MSandro93/BT_Alpha/Jobset/BT_Alpha_SCH.pdf

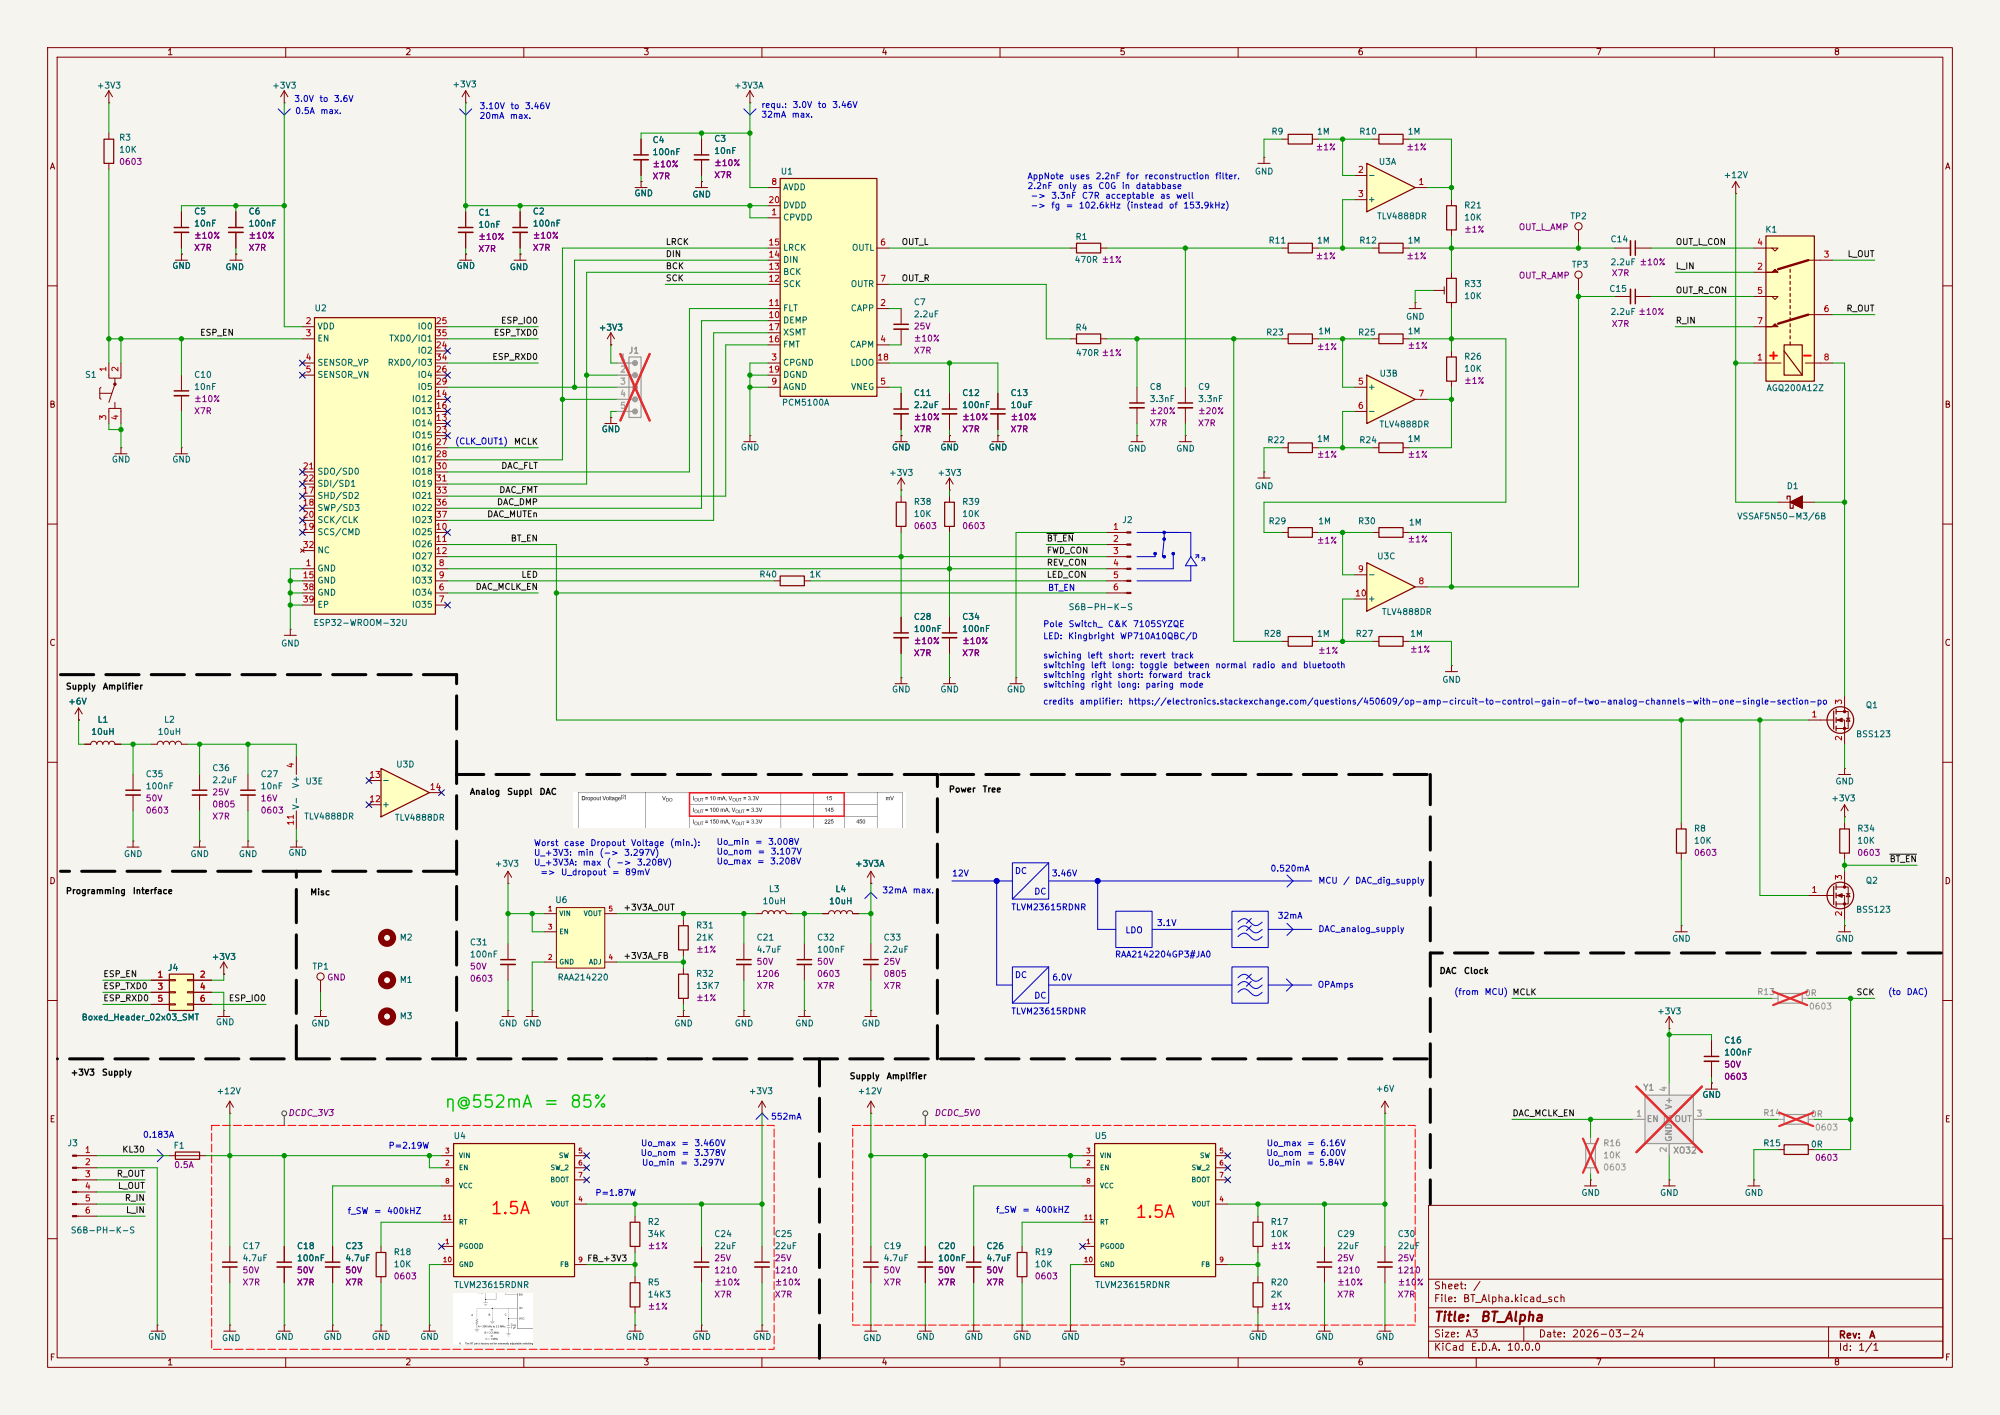
[picture p1: page 1]

AppNote uses 2.2nF for reconstruction filter. 2.2nF only as C0G in databbase -> 3.3nF C7R acceptable as well -> fg = 102.6kHz (instead of 153.9kHz)

Pole Switch_ C&K 7105SYZQE 32mA max. Analog Suppl DAC

swiching left short: revert track
switching left long: toggle between normal radio and bluetooth
switching right short: forward track

switching right long: paring mode C18

credits amplifier: https://electronics.stackexchange.com/questions/450609/op-amp-circuit-to-control-gain-of-two-analog-channels-with-one-single-section-po

Worst case Dropout Voltage (min.):
U_+3V3: min (-> 3.297V)

Size: A3 | Rev: A | F Date: 2026-03-24 KiCad E.D.A. 10.0.0
