MSandro93/BT_Alpha/Jobset/BT_Alpha_ASD.pdf

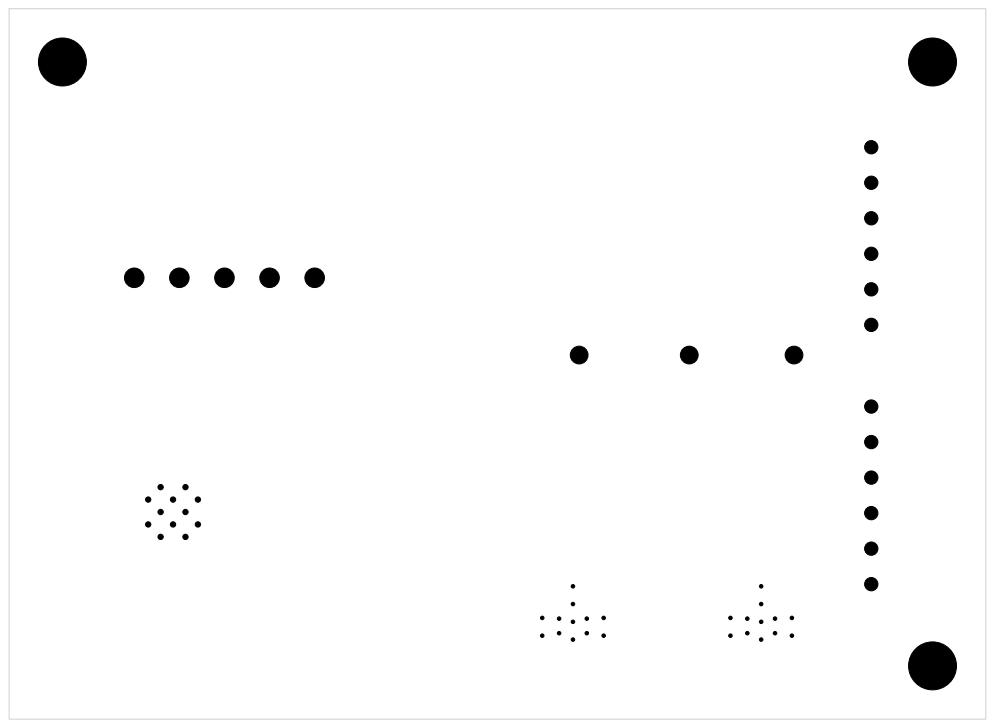
[picture p2: page 1]

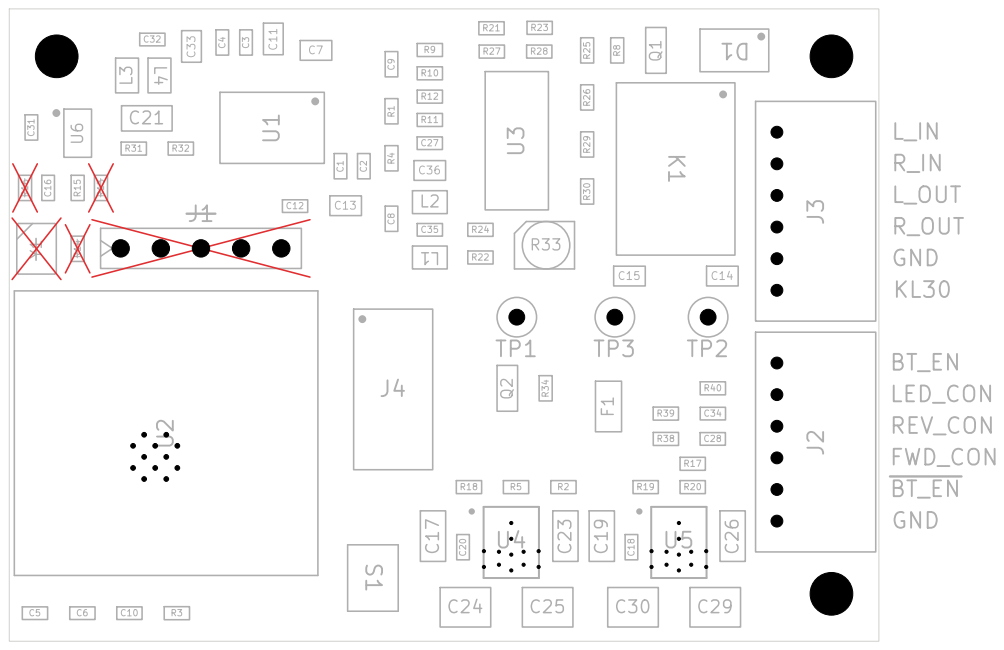
[picture p3: page 2]
