MSandro93/BT_Alpha/Jobset/BT_Alpha_Dimensions.pdf

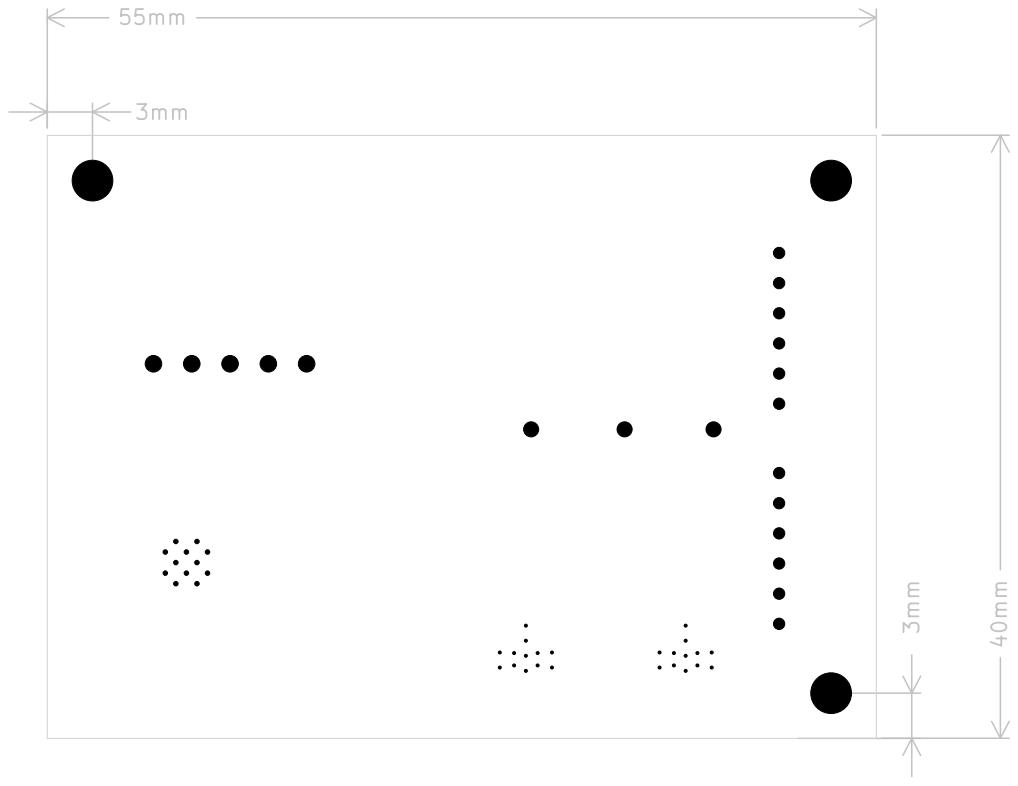
[picture p4: page 1]
