MSandro93/BT_Alpha/BT_Alpha.kicad_pcb

## KiCad design BT_Alpha.kicad_pcb (2026-05-01)

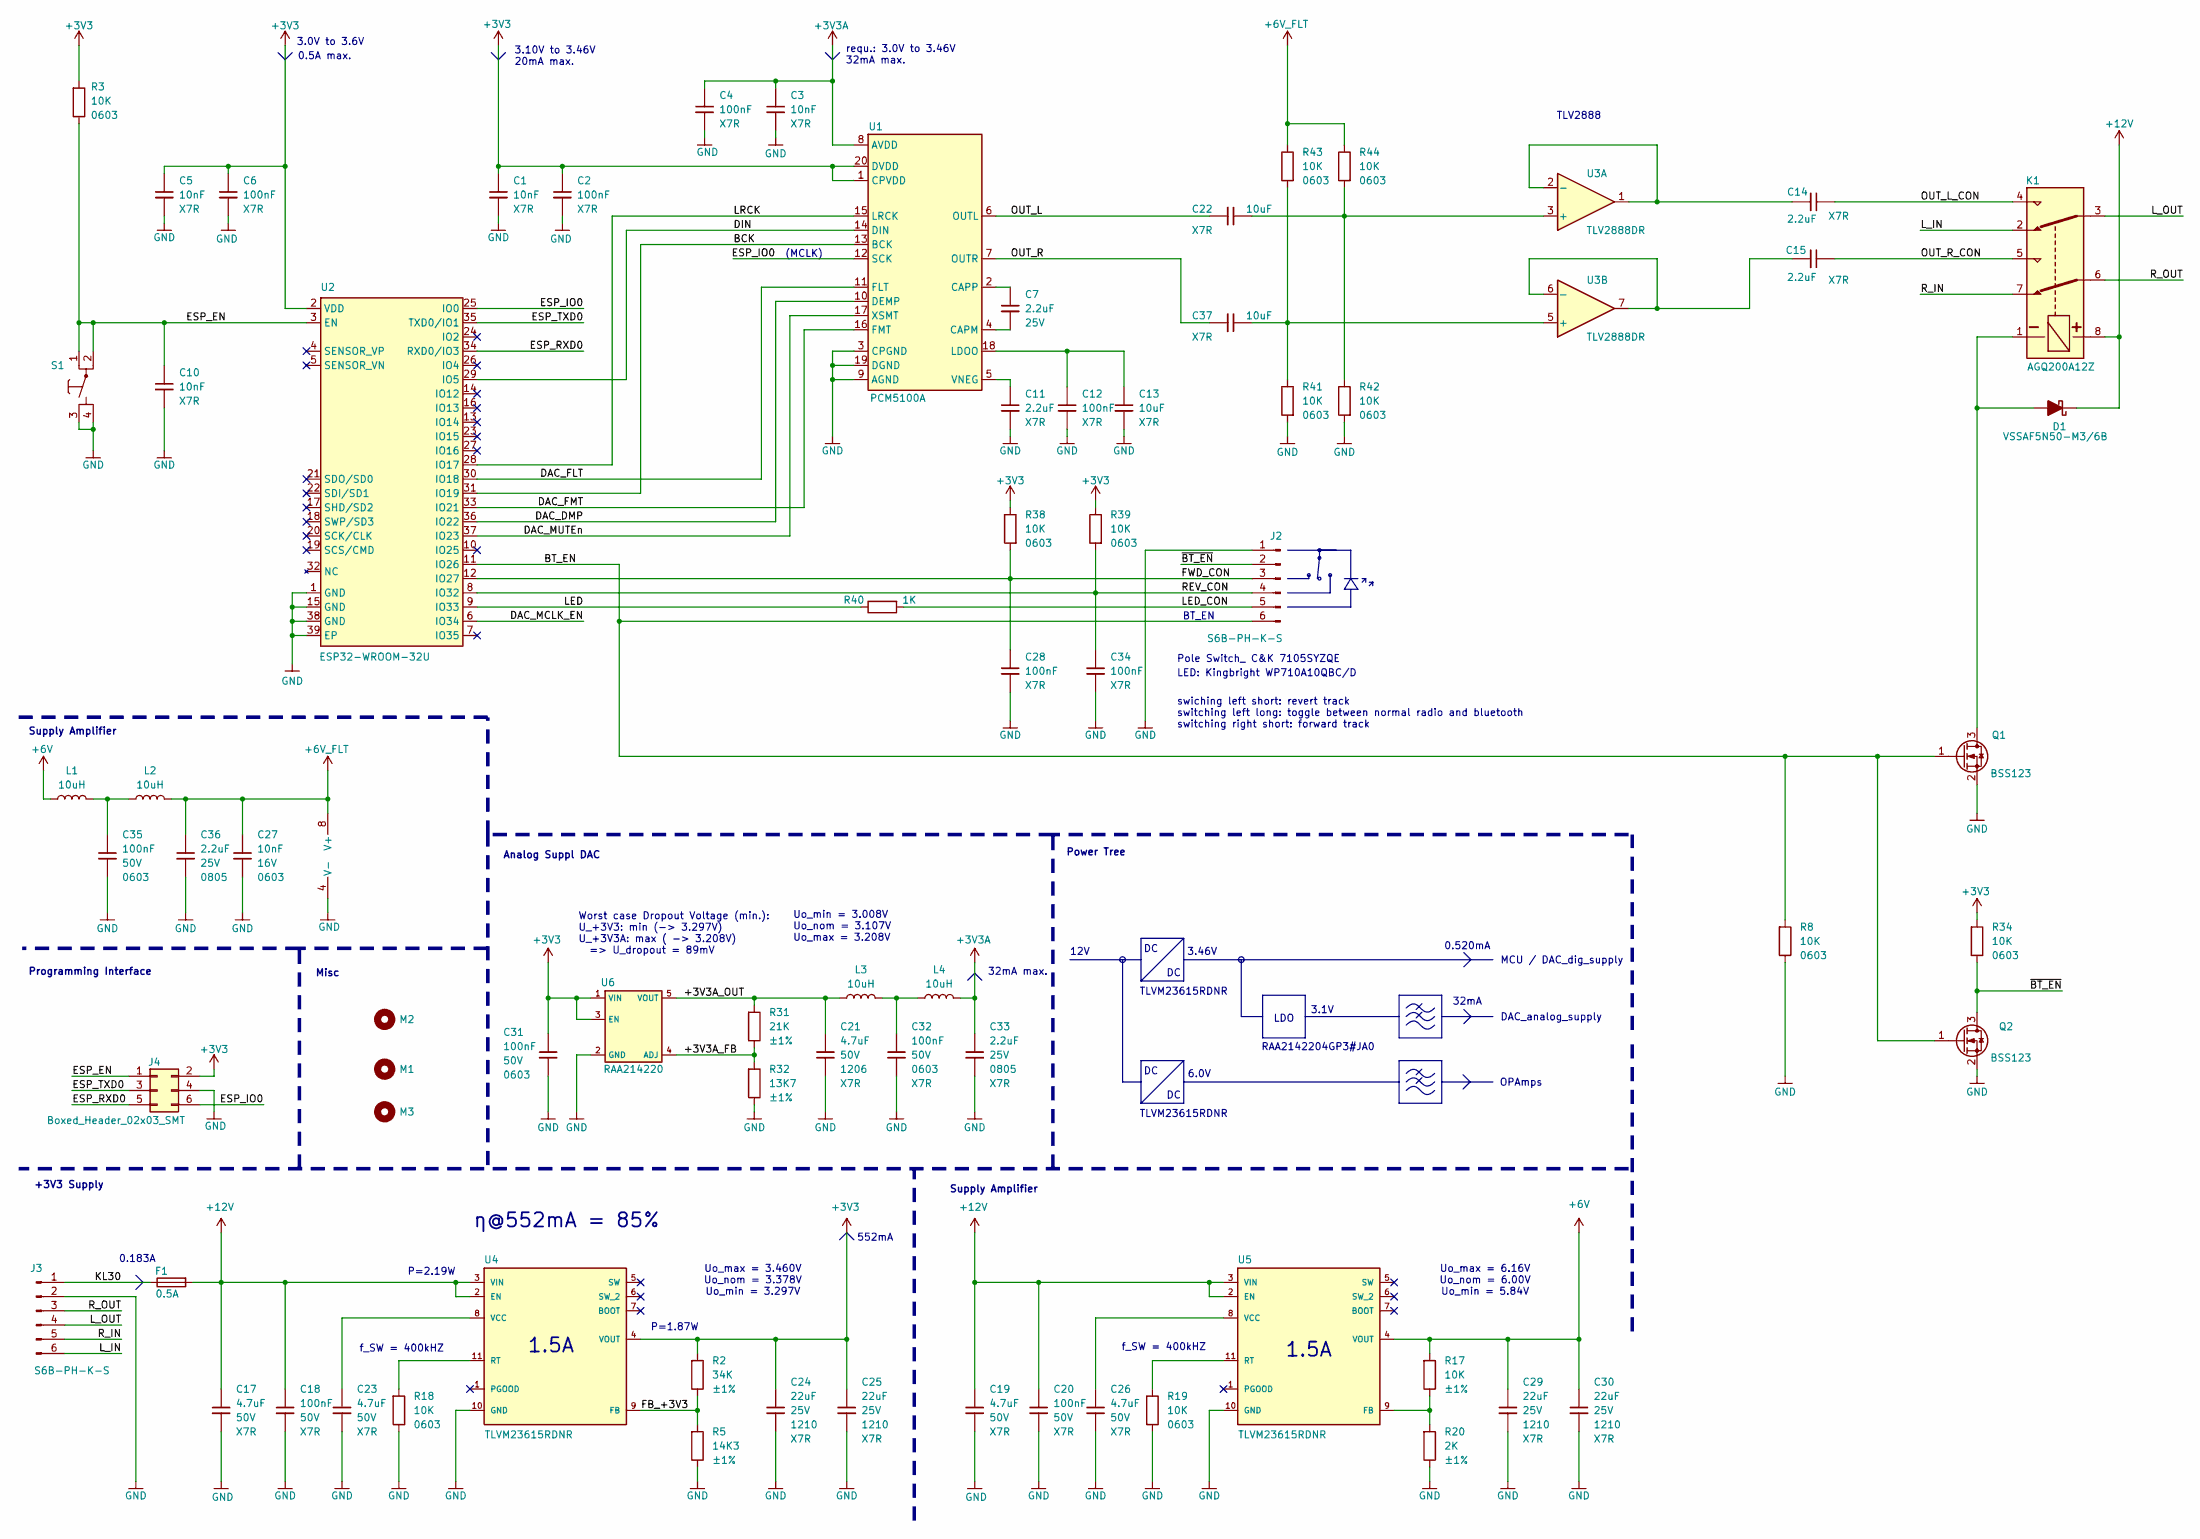
[picture p5: schematic BT_Alpha.kicad_sch]

Parts:
C1, C3, C5, C10, C27: 10nF; C_0603; Voltage 16V; Voltage [V] 16; Manufacturer Part Number 0603YC103KAT2A
C2, C4, C6, C12, C18, C20, C28, C31, C32, C34, C35: 100nF; C_0603; Voltage 50V; Voltage [V] 50; Manufacturer Part Number CL10B104KB8NNNC
C7, C11, C14, C15, C33, C36: 2.2uF; C_0805; Voltage 25V; Voltage [V] 25; Manufacturer Part Number CL21B225KAFNNNE
C13, C22, C37: 10uF; C_0805; Voltage 16V; Voltage [V] 16; Manufacturer Part Number CL21B106KOQNNNG
C17, C19, C21, C23, C26: 4.7uF; C_1206; Voltage 50V; Voltage [V] 50; Manufacturer Part Number CL31B475KBHNNNE
C24, C25, C29, C30: 22uF; C_1210; Voltage 25V; Voltage [V] 25; Manufacturer Part Number CL32B105KAFNNNE
D1: VSSAF5N50-M3/6B; VSSAF5N50; Voltage 0.56V; Voltage [V] 0.56; Manufacturer Part Number VSSAF5N50-M3/6B
F1: SF-1206S050-2; SF-1206S; Voltage [V] 63; Voltage 63VDC; Manufacturer Part Number SF-1206S050-2
J2, J3: S6B-PH-K-S; Manufacturer Part Number S6B-PH-K-S
J4: Boxed_Header_02x03_SMT
K1: AGQ200A12Z; AGQ200Axxx; Voltage [V] 12; Voltage 12V; Manufacturer Part Number AGQ200A12Z
L1, L2, L3, L4: 10uH; 74479777310; Manufacturer Part Number 74479777310
M1, M2, M3: Mounting_Hole_2.7mm_Unplated
Q1, Q2: BSS123; Voltage 100V; Voltage [V] 100; Manufacturer Part Number BSS123
R2: 34K; R_0603; Voltage 150V; Voltage [V] 150; Manufacturer Part Number RC0603FR-0734KL
R3, R8, R17, R18, R19, R34, R38, R39, R41, R42, R43, R44: 10K; R_0603; Voltage 150V; Voltage [V] 150; Manufacturer Part Number RC0603FR-0710KL
R5: 14K3; R_0603; Voltage 150V; Voltage [V] 150; Manufacturer Part Number RC0603FR-0714K3L
R20: 2K; R_0603; Voltage 150V; Voltage [V] 150; Manufacturer Part Number RC0603FR-0714K3L
R31: 21K; R_0603; Voltage 150V; Voltage [V] 150; Manufacturer Part Number RC0603FR-0721KL
R32: 13K7; R_0603; Voltage 150V; Voltage [V] 150; Manufacturer Part Number RC0603FR-0713K7L
R40: 1K; R_0603; Voltage 150V; Voltage [V] 150; Manufacturer Part Number RC0603FR-071KL
S1: 434123025826; Manufacturer Part Number 434123025826
U1: PCM5100A; PCM510xx; Manufacturer Part Number PCM5100A
U2: ESP32-WROOM-32U; WROOM_32U; Voltage 3.0 - 3.6; Voltage [V] 3.0V - 3.6V; Manufacturer Part Number ESP32-WROOM-32UE-N8
U3: TLV2888DR; Manufacturer Part Number TLV2888DR
U4, U5: TLVM23615RDNR; TxxM336x5; Manufacturer Part Number TLVM23615RDNR
U6: RAA214220; Manufacturer Part Number RAA2142204GP3#JA0

Connections:
+3V3: C1.1, C2.1, C5.1, C6.1, C24.1, C25.1, C31.1, J4.2, R2.1, R3.1, R34.1, R38.2, R39.2, U1.1 (CPVDD), U1.20 (DVDD), U2.2 (VDD), U4.4 (VOUT), U6.1 (VIN), U6.3 (EN)
+3V3A: C3.1, C4.1, C33.1, L4.2, U1.8 (AVDD)
+6V: C29.1, C30.1, L1.1, R17.1, U5.4 (VOUT)
+6V_FLT: C27.1, C36.1, L2.2, R43.2, R44.2, U3.8 (V+)
+12V: C17.1, C18.1, C19.1, C20.1, D1.K, F1.1, K1.8, U4.2 (EN), U4.3 (VIN), U5.2 (EN), U5.3 (VIN)
/+3V3A_FB: R31.2, R32.1, U6.4 (ADJ)
/+3V3A_OUT: C21.1, L3.1, R31.1, U6.5 (VOUT)
/BCK: U1.13 (BCK), U2.31 (IO19)
/BT_EN: J2.6, Q1.1 (G), Q2.1 (G), R8.1, U2.11 (IO26)
/DAC_DMP: U1.10 (DEMP), U2.36 (IO22)
/DAC_FLT: U1.11 (FLT), U2.30 (IO18)
/DAC_FMT: U1.16 (FMT), U2.33 (IO21)
/DAC_MCLK_EN: U2.6 (IO34)
/DAC_MUTEn: U1.17 (XSMT), U2.37 (IO23)
/DIN: U1.14 (DIN), U2.29 (IO5)
/ESP_EN: C10.1, J4.1, R3.2, S1.1, S1.2, U2.3 (EN)
/ESP_IO0: J4.6, U1.12 (SCK), U2.25 (IO0)
/ESP_RXD0: J4.5, U2.34 (RXD0/IO3)
/ESP_TXD0: J4.3, U2.35 (TXD0/IO1)
/FB_+3V3: R2.2, R5.1, U4.9 (FB)
/FWD_CON: C28.1, J2.3, R38.1, U2.12 (IO27)
/KL30: F1.2, J3.1
/LED: R40.2, U2.9 (IO33)
/LED_CON: J2.5, R40.1
/LRCK: U1.15 (LRCK), U2.28 (IO17)
/L_IN: J3.6, K1.2
/L_OUT: J3.4, K1.3
/OUT_L: C22.2, U1.6 (OUTL)
/OUT_L_CON: C14.1, K1.4
/OUT_R: C37.2, U1.7 (OUTR)
/OUT_R_CON: C15.1, K1.5
/REV_CON: C34.1, J2.4, R39.1, U2.8 (IO32)
/R_IN: J3.5, K1.7
/R_OUT: J3.3, K1.6
/~BT_EN: J2.2, Q2.3 (D), R34.2
GND: C1.2, C2.2, C3.2, C4.2, C5.2, C6.2, C10.2, C11.2, C12.2, C13.2, C17.2, C18.2, C19.2, C20.2, C21.2, C23.2, C24.2, C25.2, C26.2, C27.2, C28.2, C29.2, C30.2, C31.2, C32.2, C33.2, C34.2, C35.2, C36.2, J2.1, J3.2, J4.4, Q1.2 (S), Q2.2 (S), R5.2, R8.2, R18.2, R19.2, R20.2, R32.2, R41.1, R42.1, S1.3, S1.4, U1.3 (CPGND), U1.9 (AGND), U1.19 (DGND), U2.1 (GND), U2.15 (GND), U2.38 (GND), U2.39 (EP), U3.4 (V-), U4.10 (GND), U5.10 (GND), U6.2 (GND)
unnamed: C32.1, L3.2, L4.1
unnamed: C35.1, L1.2, L2.1
unnamed: D1.A, K1.1, Q1.3 (D)
unnamed: C7.2, U1.4 (CAPM)
unnamed: C7.1, U1.2 (CAPP)
unnamed: C12.1, C13.1, U1.18 (LDOO)
unnamed: C11.1, U1.5 (VNEG)
unnamed: C22.1, R42.2, R44.1, U3.3 (+)
unnamed: C14.2, U3.1, U3.2 (-)
unnamed: C37.1, R41.2, R43.1, U3.5 (+)
unnamed: C15.2, U3.6 (-), U3.7
unnamed: R18.1, U4.11 (RT)
unnamed: C23.1, U4.8 (VCC)
unnamed: R17.2, R20.1, U5.9 (FB)
unnamed: R19.1, U5.11 (RT)
unnamed: C26.1, U5.8 (VCC)

Notes on the sheet:
32mA
Supply Amplifier
Worst case Dropout Voltage (min.): U_+3V3: min (-> 3.297V) U_+3V3A: max ( -> 3.208V) => U_dropout = 89mV
DAC_analog_supply
Misc
32mA max.
1.5A
MCU / DAC_dig_supply
Power Tree
f_SW = 400kHZ
0.183A
requ.: 3.0V to 3.46V 32mA max.
Uo_min = 3.008V Uo_nom = 3.107V Uo_max = 3.208V
RAA2142204GP3#JA0
OPAmps
0.520mA
BT_EN
P=2.19W
552mA
0.5A max.
η@552mA = 85%
LED: Kingbright WP710A10QBC/D
Pole Switch_ C&K 7105SYZQE
+3V3 Supply
Uo_max = 6.16V Uo_nom = 6.00V Uo_min = 5.84V
3.10V to 3.46V 20mA max.
Uo_max = 3.460V Uo_nom = 3.378V Uo_min = 3.297V
(MCLK)
TLVM23615RDNR
3.1V
LDO
6.0V
TLV2888
P=1.87W
3.0V to 3.6V
swiching left short: revert track switching left long: toggle between normal radio and bluetooth switching right short: forward track
12V
Programming Interface
Analog Suppl DAC
3.46V

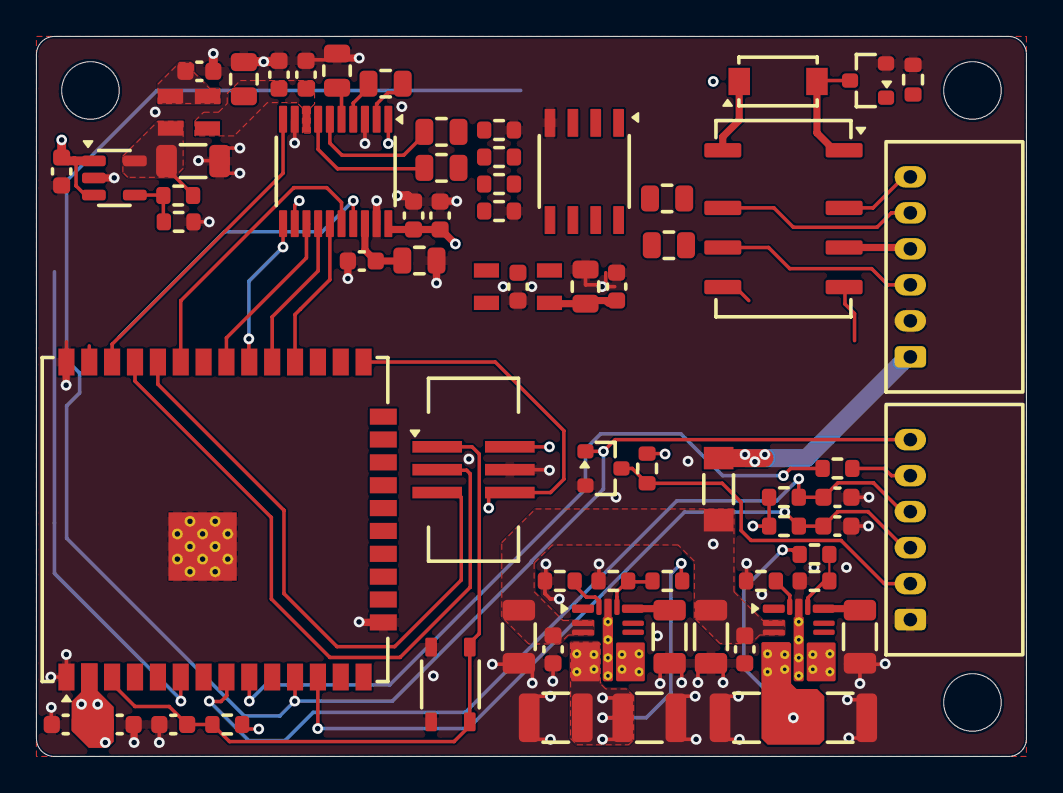
[picture p6: board BT_Alpha.kicad_pcb from above]

Board: 4 copper layers, 55.0 x 40.0 mm, 74 parts (0 on the bottom side), 51 nets.
