MSandro93/BT_Alpha/FW/BT_Alpha/include/BluetoothA2DPSinkQueued.h

#pragma once

#include "BluetoothA2DPSink.h"

#if IS_VALID_PLATFORM

#define RINGBUF_HIGHEST_WATER_LEVEL (32 * 1024)
#define RINGBUF_PREFETCH_PERCENT 65

enum A2DPRingBufferMode : char {
  RINGBUFFER_MODE_PROCESSING,  /* ringbuffer is buffering incoming audio data,
                                  I2S is working */
  RINGBUFFER_MODE_PREFETCHING, /* ringbuffer is buffering incoming audio data,
                                  I2S is waiting */
  RINGBUFFER_MODE_DROPPING /* ringbuffer is not buffering (dropping) incoming
                              audio data, I2S is working */
};

/**
 * @brief BluetoothA2DPSinkQueued provides an A2DP sink implementation with a
 * queued, task-based I2S output to address the volume delay and jitter issues
 * observed in the standard BluetoothA2DPSink implementation, especially under
 * high load or with certain Bluetooth sources.
 *
 * This class extends BluetoothA2DPSink by introducing a dedicated FreeRTOS task
 * and a ring buffer for handling audio data. Incoming audio data is buffered in
 * the ring buffer and then written to the I2S interface by the background task.
 * This design helps decouple Bluetooth and I2S timing, improving robustness
 * against jitter and allowing for prefetching and flow control.
 *
 * The ring buffer operates in different modes, controlled by the enum
 * ::A2DPRingBufferMode:
 *   - RINGBUFFER_MODE_PROCESSING: Buffering and playback are active (normal
 * operation).
 *   - RINGBUFFER_MODE_PREFETCHING: Buffering is active, playback waits until a
 * prefetch threshold is reached.
 *   - RINGBUFFER_MODE_DROPPING: Incoming audio is dropped (e.g., buffer
 * overflow or underrun recovery).
 *
 * The mode can be inspected or extended for advanced flow control and
 * diagnostics.
 *
 * Key features:
 *   - Separate I2S task for audio output
 *   - Configurable ring buffer size and prefetch threshold
 *   - Adjustable I2S task priority and stack size
 *   - Support for Arduino Print and AudioTools output
 *
 * @see A2DPRingBufferMode
 * @ingroup a2dp
 * @author Phil Schatzmann
 * @copyright Apache License Version 2
 */
class BluetoothA2DPSinkQueued : public BluetoothA2DPSink {
 public:
  BluetoothA2DPSinkQueued() = default;

#if A2DP_I2S_AUDIOTOOLS
  /// Output AudioOutput using AudioTools library
  BluetoothA2DPSinkQueued(audio_tools::AudioOutput& output) {
    actual_bluetooth_a2dp_sink = this;
    out->set_output(output);
  }
  /// Output AudioStream using AudioTools library
  BluetoothA2DPSinkQueued(audio_tools::AudioStream& output) {
    actual_bluetooth_a2dp_sink = this;
    out->set_output(output);
  }
#endif

#ifdef ARDUINO
  /// Output to Arduino Print
  BluetoothA2DPSinkQueued(Print& output) {
    actual_bluetooth_a2dp_sink = this;
    out->set_output(output);
  }
#endif

  /// Defines the stack size of the i2s task (in bytes)
  void set_i2s_stack_size(int size) { i2s_stack_size = size; }

  /// Defines the ringbuffer size used by the i2s task (in bytes)
  void set_i2s_ringbuffer_size(int size) { i2s_ringbuffer_size = size; }

  /// Audio starts to play when limit exeeded
  void set_i2s_ringbuffer_prefetch_percent(int percent) {
    if (percent < 0) return;
    if (percent > 100) return;
    ringbuffer_prefetch_percent = percent;
  }

  /// Defines the priority of the I2S task
  void set_i2s_task_priority(UBaseType_t prio) { i2s_task_priority = prio; }

  void set_i2s_write_size_upto(size_t size) { i2s_write_size_upto = size; }

  void set_i2s_ticks(int ticks) { i2s_ticks = ticks; }

 protected:
  TaskHandle_t s_bt_i2s_task_handle = nullptr; /* handle of I2S task */
  RingbufHandle_t s_ringbuf_i2s = nullptr; /* handle of ringbuffer for I2S */
  SemaphoreHandle_t s_i2s_write_semaphore = nullptr;
  // I2S task
  int i2s_stack_size = 2048;
  int i2s_ringbuffer_size = RINGBUF_HIGHEST_WATER_LEVEL;
  UBaseType_t i2s_task_priority = configMAX_PRIORITIES - 3;
  volatile A2DPRingBufferMode ringbuffer_mode = RINGBUFFER_MODE_PROCESSING;
  volatile bool is_starting = true;
  size_t i2s_write_size_upto = 240 * 6;
  int i2s_ticks = 20;
  int ringbuffer_prefetch_percent = RINGBUF_PREFETCH_PERCENT;

  void bt_i2s_task_start_up(void) override;
  void bt_i2s_task_shut_down(void) override;
  void i2s_task_handler(void* arg) override;
  size_t write_audio(const uint8_t* data, size_t size) override;

  void set_i2s_active(bool active) override {
    BluetoothA2DPSink::set_i2s_active(active);
    if (active) {
      ringbuffer_mode = RINGBUFFER_MODE_PREFETCHING;
      is_starting = true;
    }
  }

  int i2s_ringbuffer_prefetch_size() {
    int bytes = i2s_ringbuffer_size * ringbuffer_prefetch_percent / 100;
    return (bytes / 4 * 4);
  }
};

#endif  // platform
