MSandro93/BT_Alpha/FW/BT_Alpha/include/BluetoothA2DP.h

/**
 * @file BluetoothA2DP.h
 * @author Phil Schatzmann
 * @brief Includes all classes
 * @version 0.1
 * @date 2022-07-14
 * 
 * @copyright Copyright (c) 2022
 * 
 */
#pragma once

#include "BluetoothA2DPSource.h"
#include "BluetoothA2DPSink.h"
#include "BluetoothA2DPSinkQueued.h"
