MSandro93/BT_Alpha/FW/BT_Alpha/src/AudioTools/Communication/AudioPlayerControl.h

#pragma once
// Remote Control for AudioPlayer
#include "AudioPlayer/AudioPlayerProtocol.h"
#include "AudioPlayer/AudioPlayerProtocolServer.h"
#include "AudioPlayer/KARadioProtocol.h"
#include "AudioPlayer/KARadioProtocolServer.h"
