MSandro93/BT_Alpha/FW/BT_Alpha/src/AudioTools/AudioCodecs/CodecWAV.h

#pragma once

#include "AudioTools/AudioCodecs/AudioCodecsBase.h"
#include "AudioTools/AudioCodecs/AudioEncoded.h"
#include "AudioTools/AudioCodecs/AudioFormat.h"
#include "AudioTools/CoreAudio/AudioBasic/StrView.h"

#define READ_BUFFER_SIZE 512
#define MAX_WAV_HEADER_LEN 200

namespace audio_tools {

/**
 * @brief Sound information which is available in the WAV header
 * @author Phil Schatzmann
 * @copyright GPLv3
 *
 */
struct WAVAudioInfo : AudioInfo {
  WAVAudioInfo() = default;
  WAVAudioInfo(const AudioInfo &from) {
    sample_rate = from.sample_rate;
    channels = from.channels;
    bits_per_sample = from.bits_per_sample;
  }

  AudioFormat format = AudioFormat::PCM;
  int byte_rate = 0;
  int block_align = 0;
  bool is_streamed = true;
  bool is_valid = false;
  uint32_t data_length = 0;
  uint32_t file_size = 0;
  int offset = 0;
};

static const char *wav_mime = "audio/wav";

/**
 * @brief Parser for Wav header data
 * for details see https://de.wikipedia.org/wiki/RIFF_WAVE
 * @author Phil Schatzmann
 * @copyright GPLv3
 *
 */
class WAVHeader {
 public:
  WAVHeader() = default;

  /// Adds data to the 44 byte wav header data buffer and make it available for
  /// parsing
  int write(uint8_t *data, size_t data_len) {
    return buffer.writeArray(data, data_len);
  }

  /// Call begin when header data is complete to parse the data
  bool parse() {
    LOGI("WAVHeader::begin: %u", (unsigned)buffer.available());
    this->data_pos = 0l;
    memset((void *)&headerInfo, 0, sizeof(WAVAudioInfo));

    if (!setPos("RIFF")) return false;
    headerInfo.file_size = read_int32();
    if (!setPos("WAVE")) return false;
    if (!setPos("fmt ")) return false;
    int fmt_length = read_int32();
    headerInfo.format = (AudioFormat)read_int16();
    headerInfo.channels = read_int16();
    headerInfo.sample_rate = read_int32();
    headerInfo.byte_rate = read_int32();
    headerInfo.block_align = read_int16();
    headerInfo.bits_per_sample = read_int16();
    if (!setPos("data")) return false;
    headerInfo.data_length = read_int32();
    if (headerInfo.data_length == 0 || headerInfo.data_length >= 0x7fff0000) {
      headerInfo.is_streamed = true;
      headerInfo.data_length = ~0;
    }

    logInfo();
    buffer.clear();
    return true;
  }

  /// Returns true if the header is complete (containd data tag)
  bool isDataComplete() {
    int pos = getDataPos();
    return pos > 0 && buffer.available() >= pos;
  }

  /// number of bytes available in the header buffer
  size_t available() { return buffer.available(); }

  /// Determines the data start position using the data tag
  int getDataPos() {
    int pos =
        StrView((char *)buffer.data(), MAX_WAV_HEADER_LEN, buffer.available())
            .indexOf("data");
    return pos > 0 ? pos + 8 : 0;
  }

  /// provides the info from the header
  WAVAudioInfo &audioInfo() { return headerInfo; }

  /// Sets the info in the header
  void setAudioInfo(WAVAudioInfo info) { headerInfo = info; }

  /// Just write a wav header to the indicated outputbu
  int writeHeader(Print *out) {
    writeRiffHeader(buffer);
    writeFMT(buffer);
    writeDataHeader(buffer);
    int len = buffer.available();
    out->write(buffer.data(), buffer.available());
    return len;
  }

  /// Reset internal stored header information and buffer
  void clear() {
    data_pos = 0;
    WAVAudioInfo empty;
    empty.sample_rate = 0;
    empty.channels = 0;
    empty.bits_per_sample = 0;
    headerInfo = empty;
    buffer.setClearWithZero(true);
    buffer.reset();
  }

  /// Debug helper: dumps header bytes as printable characters
  void dumpHeader() {
    char msg[buffer.available() + 1];
    memset(msg, 0, buffer.available() + 1);
    for (int j = 0; j < buffer.available(); j++) {
      char c = (char)buffer.data()[j];
      if (!isalpha(c)) {
        c = '.';
      }
      msg[j] = c;
    }
    LOGI("Header: %s", msg);
  }

 protected:
  struct WAVAudioInfo headerInfo;
  SingleBuffer<uint8_t> buffer{MAX_WAV_HEADER_LEN};
  size_t data_pos = 0;

  bool setPos(const char *id) {
    int id_len = strlen(id);
    int pos = indexOf(id);
    if (pos < 0) return false;
    data_pos = pos + id_len;
    return true;
  }

  int indexOf(const char *str) {
    return StrView((char *)buffer.data(), MAX_WAV_HEADER_LEN,
                   buffer.available())
        .indexOf(str);
  }

  uint32_t read_tag() {
    uint32_t tag = 0;
    tag = (tag << 8) | getChar();
    tag = (tag << 8) | getChar();
    tag = (tag << 8) | getChar();
    tag = (tag << 8) | getChar();
    return tag;
  }

  uint32_t getChar32() { return getChar(); }

  uint32_t read_int32() {
    uint32_t value = 0;
    value |= getChar32() << 0;
    value |= getChar32() << 8;
    value |= getChar32() << 16;
    value |= getChar32() << 24;
    return value;
  }

  uint16_t read_int16() {
    uint16_t value = 0;
    value |= getChar() << 0;
    value |= getChar() << 8;
    return value;
  }

  void skip(int n) {
    int i;
    for (i = 0; i < n; i++) getChar();
  }

  int getChar() {
    if (data_pos < buffer.size())
      return buffer.data()[data_pos++];
    else
      return -1;
  }

  void seek(long int offset, int origin) {
    if (origin == SEEK_SET) {
      data_pos = offset;
    } else if (origin == SEEK_CUR) {
      data_pos += offset;
    }
  }

  size_t tell() { return data_pos; }

  bool eof() { return data_pos >= buffer.size() - 1; }

  void logInfo() {
    LOGI("WAVHeader sound_pos: %d", getDataPos());
    LOGI("WAVHeader channels: %d ", headerInfo.channels);
    LOGI("WAVHeader bits_per_sample: %d", headerInfo.bits_per_sample);
    LOGI("WAVHeader sample_rate: %d ", (int)headerInfo.sample_rate);
    LOGI("WAVHeader format: %d", (int)headerInfo.format);
  }

  void writeRiffHeader(BaseBuffer<uint8_t> &buffer) {
    buffer.writeArray((uint8_t *)"RIFF", 4);
    write32(buffer, headerInfo.file_size - 8);
    buffer.writeArray((uint8_t *)"WAVE", 4);
  }

  void writeFMT(BaseBuffer<uint8_t> &buffer) {
    uint16_t fmt_len = 16;
    buffer.writeArray((uint8_t *)"fmt ", 4);
    write32(buffer, fmt_len);
    write16(buffer, (uint16_t)headerInfo.format);  // PCM
    write16(buffer, headerInfo.channels);
    write32(buffer, headerInfo.sample_rate);
    write32(buffer, headerInfo.byte_rate);
    write16(buffer, headerInfo.block_align);  // frame size
    write16(buffer, headerInfo.bits_per_sample);
  }

  void write32(BaseBuffer<uint8_t> &buffer, uint64_t value) {
    buffer.writeArray((uint8_t *)&value, 4);
  }

  void write16(BaseBuffer<uint8_t> &buffer, uint16_t value) {
    buffer.writeArray((uint8_t *)&value, 2);
  }

  void writeDataHeader(BaseBuffer<uint8_t> &buffer) {
    buffer.writeArray((uint8_t *)"data", 4);
    write32(buffer, headerInfo.file_size);
    int offset = headerInfo.offset;
    if (offset > 0) {
      uint8_t empty[offset];
      memset(empty, 0, offset);
      buffer.writeArray(empty, offset);  // resolve issue with wrong aligment
    }
  }
};
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
