MSandro93/BT_Alpha/(commit log)

2026-03-26 rough placement
    [BT.kicad_pcb]
2026-03-27 added amplifier. So control volume by knob, signal has to be in injected before the volume control poti. This is why around 5V signal amplitude are necessary.
    [BT.kicad_pcb]
2026-03-28 Increased intermediate rail from 5 to 6V; replaced LDO for diigital supply by DCDC
    [BT.kicad_pcb]
2026-03-28 clean up
    [BT.kicad_pcb, BT.kicad_sch, Programming_Interface.kicad_sch]
2026-03-28 integrated DAC in database
    [BT.kicad_pcb, BT.kicad_sch]
2026-03-30 rough placement PSU
    [BT.kicad_pcb, BT.kicad_sch]
2026-04-03 replaced all components by library parts
    [BT.kicad_pcb, BT.kicad_sch]
2026-04-03 started layout
    [BT.csv, BT.kicad_pcb, BT.kicad_sch]
2026-04-04 almost finished layout. Something is still off in the design rules
    [BT.kicad_pcb, BT.kicad_sch]
2026-04-04 added teardrops
    [BT.kicad_pcb]
2026-04-10 added signals
    [BT-B_Cu.gbl, BT-B_Mask.gbs, BT-B_Paste.gbp, BT-B_Silkscreen.gbo, BT-Edge_Cuts.gm1, BT-F_Cu.gtl, BT-F_Mask.gts, BT-F_Paste.gtp]
2026-04-11 Release Rev. A
    [BT-B_Cu.gbl, BT-B_Mask.gbs, BT-B_Paste.gbp, BT-B_Silkscreen.gbo, BT-Edge_Cuts.gm1, BT-F_Cu.gtl, BT-F_Mask.gts, BT-F_Paste.gtp]
2026-04-11 renamed project
    [BT_Alpha.kicad_pcb, BT_Alpha.kicad_sch]
2026-04-11 Updated Jobset
    [BT_Alpha-B_Cu.gbl, BT_Alpha-B_Mask.gbs, BT_Alpha-B_Paste.gbp, BT_Alpha-B_Silkscreen.gbo, BT_Alpha-Edge_Cuts.gm1, BT_Alpha-F_Cu.gtl, BT_Alpha-F_Mask.gts, BT_Alpha-F_Paste.gtp]
2026-04-18 added iBoM
    [BT_Alpha.kicad_pcb]
2026-04-21 rounded edges
    [BT_Alpha.kicad_pcb, BT_Alpha.kicad_sch]
2026-04-28 started iterating to rev. B
    [BT_Alpha.kicad_pcb, BT_Alpha.kicad_sch, history.kicad_sch]
2026-04-28 added credits
    [BT_Alpha.kicad_pcb, BT_Alpha.kicad_sch]
2026-04-30 fixed state machine
    [BT_Alpha.kicad_sch]
2026-05-01 added dimensioning for mounting hole diameter
    [BT_Alpha.kicad_pcb]
